eggsactly/arduino-wardriving/mount/central-mount.scad

include <libparameters.scad>;
use <libcantilever.scad>;
use <libtriangles.scad>;

function rotateRoundCant(i, j) = (i == -1) ? (j == -1) ? 315 : 225 : (j == -1) ? 45 : 135;

// Draw the elements
difference() 
{
    union()
    {   
        // Draw the main body
        translate(v = [-plateWidth/2, plateOffsetY, 0])
        {
            minkowski()
            {
                cube([plateWidth, plateLength, plateHeight/2], center = false);
                cylinder(h = plateHeight/2, r = minBodyMargin, center = false, $fn = 360);
            }
        }
    
        // Draw the risers
        for (i = [-1, 1])
        {
            for(j = [-1, 1]){
                translate(v = [i * (featherWingDoublerWidth/2 - screwHoleCenterFromEdge), j*(featherWingDoublerLength/2 - screwHoleCenterFromEdge) - batteryDiameter/2 - batteryMargin, plateHeight]) {
                    cylinder(h = solderHeight, r1 = riserBase, r2 = screwHoleCenterFromEdge, center = false, $fn = 360);
                    // Featherboard support block
                    difference(){
                        // Feather board support
                        rotate([0, 0, rotateRoundCant(i, j)-135])translate([-screwHoleCenterFromEdge, -screwHoleCenterFromEdge])cube([riserBase + screwHoleCenterFromEdge, riserBase + screwHoleCenterFromEdge, solderHeight + circularCantLen + featherBoardThickness]);
                        // Circular Cutout
                        translate([0, 0, solderHeight])cylinder(h = solderHeight, r = screwHoleCenterFromEdge, center = false, $fn = 360);
                        rotate([0, 0, rotateRoundCant(i, j)-135-180]){
                            translate([0, 0, solderHeight])cube([screwHoleCenterFromEdge + 1, screwHoleCenterFromEdge + 1, solderHeight]);
                            translate([-screwHoleCenterFromEdge, 0, solderHeight])cube([screwHoleCenterFromEdge + 1, screwHoleCenterFromEdge + 1, solderHeight]);
                            translate([0, -screwHoleCenterFromEdge, solderHeight])cube([screwHoleCenterFromEdge + 1, screwHoleCenterFromEdge + 1, solderHeight]);
                            translate([0, 0, 0])cube([screwHoleCenterFromEdge + 1, screwHoleCenterFromEdge + 1, solderHeight + 1]);
                        }
                    }
                }
            }      
        }
         
    
        // Draw the switch support
        translate([0, plateOffsetY + 6*fitMargin, plateHeight]) {
            translate([switchWidth/2 + switchSupportWidth, - batConLength, 0])rotate([90, 0, 0])triangle(switchHeight, switchLength, switchSupportWidth + 1/3);
            translate([-switchWidth/2 - switchSupportWidth, -switchLength - batConLength, 0])cube([switchSupportWidth, switchLength, switchHeight]);
            translate([-switchWidth/2 - switchSupportWidth, - batConLength - switchLength, 0])rotate([90, 0, 180])triangle(switchHeight, switchLength, switchSupportWidth + 1/3);
            translate([switchWidth/2, -switchLength - batConLength, 0])cube([switchSupportWidth, switchLength, switchHeight]);
       
        }
        // Draw the battery connector support
        translate([-(featherWingDoublerWidth/2 - screwHoleCenterFromEdge) - batConWidth/2, -(featherWingDoublerLength/2 - screwHoleCenterFromEdge) - batteryDiameter/2 - batteryMargin - batConShroudWidth - screwHoleCenterFromEdge, plateHeight]) {
            translate([0, 0, 0])cube([batConWidth, batConShroudWidth, batConHeight]);
            translate([0, -batConWidth-batConShroudWidth, 0])cube([batConWidth, batConShroudWidth, batConHeight]);
            translate([batConWidth, - batConWidth - batConShroudWidth, 0])rotate([90, 0, -90])triangle(batConHeight, batConShroudWidth, batConWidth);
        }
    
    
    }

    difference()
    {
        // Draw the attachment adaptor hole
        translate(v = [-(bikeMountHeight + 2 * fitMargin)/2, -(bikeMountHeight + 2 * fitMargin)/2, -0.5]) 
        {
            cube([bikeMountHeight + 2 * fitMargin, bikeMountHeight + 2 * fitMargin, plateHeight + 1], center = false);
        }
        // Draw the central cantilever mount
        for(i=[0 : 90 : 270])rotate([0, 0, i])translate([-(bikeMountHeight + 2 * fitMargin)/2, 0, plateHeight - handle_cant_slope_height - handle_cant_errosion_margin - fitMargin])translate([0, (bikeMountHeight + 2 * fitMargin)/2, 0])rotate([0, 90, -90])cantilever(0, central_cant_errosion_margin, central_cant_slope_height, handle_cant_overhang, 0, 0, bikeMountHeight + 2 * fitMargin);
    }

    // Draw the hole for the battery mount
    difference()
    {
        // 
        union(){
            // Draw the main block
            translate([-(batterySheathLength + 2 * fitMargin)/2, batteryPlateOffsetY - 2*fitMargin, -0.5])cube([batterySheathLength + 2 * fitMargin, batteryPlankWidth + 2 * fitMargin, plateHeight + 1]);
            //Draw the near triangle
            translate([-(batterySheathLength + 2 * fitMargin)/2, batteryPlateOffsetY - 2*fitMargin, 0]){
                rotate([0, -90, 180])triangle(4, handle_cant_post_height + handle_cant_slope_height + handle_cant_errosion_margin, batterySheathLength + 2 * fitMargin);
                translate([0, -4, -0.5])cube([batterySheathLength + 2 * fitMargin, 4, 1]);
                translate([0, -0.5, -0.5])cube([batterySheathLength + 2 * fitMargin, 1, handle_cant_post_height + handle_cant_slope_height + handle_cant_errosion_margin]);
            }
            // Draw the far triangle
            translate([(batterySheathLength + 2 * fitMargin)/2, batteryPlateOffsetY - 2*fitMargin + batteryPlankWidth + 2 * fitMargin, 0])rotate([0, 0, 180]){
                rotate([0, -90, 180])triangle(4, handle_cant_post_height + handle_cant_slope_height + handle_cant_errosion_margin, batterySheathLength + 2 * fitMargin);
                translate([0, -4, -0.5])cube([batterySheathLength + 2 * fitMargin, 4, 1]);
                translate([0, -0.5, -0.5])cube([batterySheathLength + 2 * fitMargin, 1, handle_cant_post_height + handle_cant_slope_height + handle_cant_errosion_margin]);
            }
        }
        
        // Draw the battery connect block
        translate([-batterySheathLength/2 - fitMargin, batteryPlateOffsetY + (batteryPlankWidth - batteryBlockLength)/2 - fitMargin, 0])cube([batterySheathLength + 4*fitMargin, batteryBlockLength, handle_cant_errosion_margin + handle_cant_slope_height + handle_cant_post_height + fitMargin]);
    
        // Draw the far cantilever fitting for the batter mount
        translate([0, batteryBlockLength + (batteryPlankWidth - batteryBlockLength)/2 - fitMargin, 0])      
            rotate([0, 0, 0])translate([batterySheathLength/2 + fitMargin, batteryPlateOffsetY, handle_cant_errosion_margin + handle_cant_slope_height + 2*fitMargin])
                rotate([0, -90, 0])
                    cantilever(0, 2, handle_cant_post_height - 2 - 2 * fitMargin, handle_cant_overhang, 0, 0, batterySheathLength + 2 * fitMargin);
        
        // Draw the near cantilever fitting for the battery mount
        translate([0, (batteryPlankWidth - batteryBlockLength)/2 - fitMargin, 0])      
            rotate([0, 0, 0])translate([-batterySheathLength/2 - fitMargin, batteryPlateOffsetY, handle_cant_errosion_margin + handle_cant_slope_height + 2*fitMargin])
                rotate([0, -90, 180])
                    cantilever(0, 2, handle_cant_post_height - 2 - 2 * fitMargin, handle_cant_overhang, 0, 0, batterySheathLength + 2 * fitMargin);
    }
    
    // Draw the little holes to put you fingers in
    for(i = [(bikeMountHeight + 2 * fitMargin)/2, -(bikeMountHeight + 2 * fitMargin)/2])translate([i, 0, plateHeight])sphere(r=fingerHoleRadius, $fn = 60);
        for(i = [(bikeMountHeight + 2 * fitMargin)/2, -(bikeMountHeight + 2 * fitMargin)/2])translate([0, i, plateHeight])sphere(r=fingerHoleRadius, $fn = 60);
       
     // Draw the repo text, lots of nasty hard coding here
    translate([plateWidth/2 + 7, -22, plateHeight-textHeight+0.5])
    {
        rotate([0, 0, 180]){
            translate([0, 0, -0.5])rotate([0, 0, -90])linear_extrude(height=textHeight+1)text(text=repoURL, size = 4.5);
        }
    } 
}
