eggsactly/arduino-wardriving/mount/handlebar-mount-up.scad

include <libparameters.scad>;
use <libcantilever.scad>;

// Move the whole block to start on the X axis
translate([0, -handleBarConnectorSeparation/2, 0])
difference()
{
    union()
    {
        // Draw the main block
        translate([-handleBarDiameter/2 - handleBarMountThickness + attachAdaptorBezzelRad, attachAdaptorBezzelRad  + handleBarConnectorSeparation/2, 0]){
            minkowski()
            {
                cube([handleBarDiameter + 2*handleBarMountThickness-2*attachAdaptorBezzelRad, handleBarDiameter/2 + handleBarMountThickness - 2*attachAdaptorBezzelRad - handleBarConnectorSeparation/2 + mountPostLength, bikeMountHeight/2]);
                cylinder(h = bikeMountHeight/2, r = attachAdaptorBezzelRad, center = false, $fn = 360);
            }
        }
        
        // Draw the left support
        translate([handleBarDiameter/2,  + handleBarConnectorSeparation/2, 0])
            cube([handleBarScrewMountWidth, handleBarMatingPlateThickness, bikeMountHeight]);
        // Draw the right support
        translate([-handleBarDiameter/2 - handleBarScrewMountWidth,  + handleBarConnectorSeparation/2, 0])
            cube([handleBarScrewMountWidth, handleBarMatingPlateThickness, bikeMountHeight]);
        
        // Draw the mount fit
        translate([-bikeMountHeight/2, handleBarDiameter/2 + handleBarMountThickness - handleBarConnectorSeparation/2 + handleBarConnectorSeparation/2 + mountPostLength, 0])
            cube([bikeMountHeight, mountFitHeight, bikeMountHeight]);
        
        // Draw left cantilever
        translate([bikeMountHeight/2 - handle_cant_length_end - handle_cant_overhang, handleBarDiameter/2 + handleBarMountThickness - handleBarConnectorSeparation/2 + handleBarConnectorSeparation/2 + mountPostLength + mountFitHeight, bikeMountHeight - handle_cant_overhang])rotate([0, 180, -90])cantilever (handle_cant_post_height, handle_cant_errosion_margin, handle_cant_slope_height, handle_cant_overhang, handle_cant_length, handle_cant_length_end, bikeMountHeight - 2 * handle_cant_overhang);
        
       // Draw right cantilever
       translate([-bikeMountHeight/2 + handle_cant_length_end + handle_cant_overhang, handleBarDiameter/2 + handleBarMountThickness - handleBarConnectorSeparation/2 + handleBarConnectorSeparation/2 + mountPostLength + mountFitHeight, handle_cant_overhang])rotate([0, 0, 90])cantilever (handle_cant_post_height, handle_cant_errosion_margin, handle_cant_slope_height, handle_cant_overhang, handle_cant_length, handle_cant_length_end, bikeMountHeight - 2 * handle_cant_overhang);
    }
    
    // Draw handlebar hole
    translate([0, 0, -0.5])
        cylinder(h = bikeMountHeight+1, d = handleBarDiameter, center = false, $fn = 360);
    
    // Draw left Screw Hole
    translate([handleBarDiameter/2 + handleBarMountThickness + screwMargin + m3HeadDiameter/2, -0.5  + handleBarConnectorSeparation/2, bikeMountHeight/2])rotate([-90, 0, 0]) cylinder(h = handleBarMatingPlateThickness + 1, d = m3ThreadDiameter, center = false, $fn = 360);
    
    // Draw right nut hole
    translate([handleBarDiameter/2 + handleBarMountThickness + screwMargin + m3HeadDiameter/2, handleBarMatingPlateThickness - m3NutHeight  + handleBarConnectorSeparation/2, bikeMountHeight/2])rotate([-90, 0, 0]) cylinder(h = m3NutHeight + 1, d = m3NutWidth, center = false, $fn = 6);
    
    // Draw Right Screw Hole
    translate([-handleBarDiameter/2 - handleBarMountThickness - screwMargin - m3HeadDiameter/2, -0.5  + handleBarConnectorSeparation/2, bikeMountHeight/2])rotate([-90, 0, 0]) cylinder(h = handleBarMatingPlateThickness + 1, d = m3ThreadDiameter, center = false, $fn = 360);
    
    // Draw right nut hole
    translate([-handleBarDiameter/2 - handleBarMountThickness - screwMargin - m3HeadDiameter/2, handleBarMatingPlateThickness - m3NutHeight  + handleBarConnectorSeparation/2, bikeMountHeight/2])rotate([-90, 0, 0]) cylinder(h = m3NutHeight + 1, d = m3NutWidth, center = false, $fn = 6);
}
