eggsactly/arduino-wardriving/(list of files, cad)

Other CAD files:
mount/libtriangles.scad
