eggsactly/arduino-wardriving/(commit log)

2018-01-02 Moved wardriving sketch into its own folder to work with arduino version 2:1.0.5+dfsg2-4.1
2018-01-17 Replaced lcd with Adafruit_SSD1306.
    [wardriving.ino]
2018-01-17 Removed extranious files.
    [GPSLOG_example.csv, schematic.fzz]
2018-01-17 Added diagram of feather-wing-doubler circuit.
2018-01-17 Removed Ebay link to powerpack.
2018-02-03 Made GPS come in on the dedicated serial port and made hdop print to SD card.
2018-02-03 Added fix detect logic.
    [wardriving.ino]
2018-02-05 Added resistors to the parts list.
2018-02-15 Added battery icon.
2018-02-19 Added code for buttons A and B.
2018-02-20 Added functionality to buttons.
2018-02-21 Changed to fritzing diagram, changed resistor values in parts list.
2018-02-21 Added links to resistors.
2018-03-16 Added initial mount model for the featherwing doubler.
    [mount.scad]
2018-03-16 Added bevel to mount.
    [mount.scad]
2018-03-16 Made centering false, made no parts go below zero on the z axis.
    [mount.scad]
2018-03-16 Added space on plate for battery.
    [mount.scad]
2018-03-16 Gave risers a good 45 degree slope up.
    [mount.scad]
2018-03-17 Added mount attachment point.
    [mount.scad]
2018-03-17 Put parameters in a dedicated parameters file.
    [mount.scad, parameters.scad]
2018-03-17 Added battery adaptor mount.
    [battery-adaptor.scad, parameters.scad]
2018-03-18 Added screw holes for batter mount on main mount.
    [mount.scad, parameters.scad]
2018-03-21 Added the bike mount.
    [bike-mount.scad, parameters.scad]
2018-03-22 Extended slider length
    Extended slider support length to be most of the bike mount width.
    [bike-mount.scad]
2018-03-23 Added Bike mount slider and screw hole.
    [bike-mount.scad, parameters.scad]
2018-03-23 Put bike mount parameters into parameters file.
    [bike-mount.scad, parameters.scad]
2018-03-23 Added rounded outside corners of the bike mount.
    [bike-mount.scad]
2018-03-25 Added handle bar mounts.
    [handle-bar-lower.scad, handle-bar-upper.scad]
2018-03-25 Made the thread diameter just a little bit bigger.
    [parameters.scad]
2018-03-25 Made handle-bar-upper model one object.
    [bike-mount.scad, handle-bar-upper.scad]
2018-03-25 Fixed m3NutWidth calculation to give correct cylinder radius for nut hole.
    [handle-bar-upper.scad]
2018-03-25 Moved more parameters into parameters.scad.
    [handle-bar-lower.scad, handle-bar-upper.scad, parameters.scad]
2018-03-25 Removed extra parameters from handle-bar-upper.scad.
    [handle-bar-upper.scad]
2018-03-26 Renamed mount files, made Makefile.
    [battery-mount.scad, central-mount.scad, handlebar-mount-low.scad, handlebar-mount-up.scad]
2018-03-28 Feather Wing configuration images.
2018-03-28 Added h3 headers for electric setup feather wing sections.
2018-04-01 Added an 8mm separation between the lower and upper handlebar mount.
    [handlebar-mount-low.scad, handlebar-mount-up.scad, parameters.scad]
2018-04-01 Increased the screw radius because actual 3D prints were smaller than radius.
    [parameters.scad]
2018-04-01 Added a cantilever library.
    [libcantilever.scad]
2018-04-01 Switched mount make file to not build anything with lib in front of it.
    [battery-mount.scad, bike-mount.scad, central-mount.scad, handlebar-mount-low.scad, handlebar-mount-up.scad, libcantilever.scad, libparameters.scad]
2018-04-02 Replaced slider on handlebar-mount-up with cantilever.
    [handlebar-mount-up.scad]
2018-04-02 Made the post on the handlebar-mount-up longer and made the cantilevers smaller.
    [handlebar-mount-up.scad]
2018-04-07 Narrowed handle bar attachment cantilevers to allow it to plug in 4 different ways.
    [handlebar-mount-up.scad]
2018-04-07 Moved handlebar-mount-up to start on X axis.
    [handlebar-mount-up.scad]
2018-04-07 Adjusted the cantilever x position and z height.
    [handlebar-mount-up.scad]
2018-04-07 Adjusted the handlebar mount up cantilever length.
    [handlebar-mount-up.scad]
2018-04-10 Renamed cantiliver settings for handlebar mount and put them in libparameters.
    [handlebar-mount-up.scad, libparameters.scad]
2018-04-10 Updated handelbar mount up.
    [handlebar-mount-up.scad]
2018-04-10 Took out attachment adaptor screw holes.
    [central-mount.scad]
2018-04-10 Made attachment adaptor hole the width and length of bikeMountHeight.
    [central-mount.scad, handlebar-mount-up.scad]
2018-04-10 Added cantilever slot on central mount for bike mount.
    [central-mount.scad, libparameters.scad]
2018-04-17 Replaced screw holes on the battery mount with cantilevers.
    [battery-mount.scad, libparameters.scad]
2018-04-28 Used mountFitHeight as the height for the fit peice on the battery mount.
    [battery-mount.scad]
2018-04-29 Replaced the battery screwholes with a slot.
    [central-mount.scad, libparameters.scad]
2018-04-29 Made central mount margins smaller to use less plastic.
    [central-mount.scad, libparameters.scad]
2018-04-29 Added batter connect block to central mount.
    [central-mount.scad]
2018-04-29 Finished the cantilever fitting on the central mount for the battery mount.
    [central-mount.scad]
2018-05-05 Added round cantilevers to central mount for featherwing doubler mount.
    [central-mount.scad, libRoundCantilever.scad, libparameters.scad]
2018-05-11 Made better calculation for plateLength.
    [libparameters.scad]
2018-05-11 Updated comments to central mount.
    [central-mount.scad]
2018-05-11 Fixed calculation for batteryPlateOffsetY.
    [central-mount.scad, libparameters.scad]
2018-05-18 Added mount for power switch.
    [central-mount.scad, libparameters.scad]
2018-05-18 Added spot for batter connector.
    [central-mount.scad]
2018-05-22 Pushed the switch mount back a fitMargin.
    [central-mount.scad]
2018-05-22 Added triangles to the sides of the switch support.
    [central-mount.scad, libtriangles.scad]
2018-05-22 Added triangle to battery connector mount.
    [central-mount.scad]
2018-05-22 Added secondary support surround for featherboard doubler.
    [central-mount.scad, libparameters.scad]
2018-05-23 Added text to repo.
    [central-mount.scad, libparameters.scad]
2018-05-25 Fixed tabbing in central mount.
    [central-mount.scad]
2018-05-25 Added more support for the featherwing doubler on the blocks.
    [central-mount.scad]
2018-05-25 Expanded screwHoleCenterFromEdge by 0.2mm, which controls the radius of the feather board corners.
    [libparameters.scad]
2018-05-25 Put repo text on other side so that it won't be obscured by the battery wire.
    [central-mount.scad]
2018-05-25 Fixed tabing in battery mount.
    [battery-mount.scad]
2018-05-25 Made some adjustments to the mount around the batter mount, to ensure a good fit.
    [central-mount.scad]
2018-05-25 Moved git text to keep it out of the way of the battery.
    [central-mount.scad]
2018-05-25 Removed bike mount part because it was taken out of the design.
    [bike-mount.scad]
2018-05-25 Added comments to the mount Makefile.
2018-05-25 Removed echo in libparameters.
    [libparameters.scad]
2018-05-25 Increased finger hole resolution from 30 to 60.
    [central-mount.scad]
2018-05-25 Added link to socket cap screws.
2018-05-25 Added section for the parts in mount.
2018-05-25 Updated mount images.
2018-05-25 Made it more clear what pins should be attached to which board.
2018-05-26 Added functionality for button C release.
2018-05-27 Got rid of that weird outer union for the bike mount post interface.
    [central-mount.scad]
2018-05-28 Updated button recording code.
2018-06-01 Took out round cantilevers because they don't print well.
    [central-mount.scad, libRoundCantilever.scad]
2018-06-01 Made the repo text just be a difference on the main plate.
    [central-mount.scad]
2018-06-01 Made repo text size 4.5 to increase chances it will print correctly.
    [central-mount.scad]
2018-06-02 Implemented state machine for keeping track of setting menu states.
2018-06-05 Added printout to LCD screen.
2018-06-08 Added logic for missing SD card.
    [wardriving.ino]
2018-06-08 Got SD card print out to fit in 3 lines.
2018-06-08 Made battery and display update at same time and only wrote header when SD is available.
2018-06-08 Fixed printout alignments.
2018-06-08 Kept n from being reset on a lcd screen refresh.
    [wardriving.ino]
2018-06-09 Made print out not give GPS Updating when buttons pressed.
2018-06-11 Changed output for default case of getEncryption() to be UNKNOWN: id.
2018-06-13 Created a os timer and call back to put button detection into.
2018-06-13 Moved button detection code to timerCallback().
2018-06-16 Made printouts more helpful to the user.
2018-06-16 Made python scripts filter out SSIDs that are not valid UTF-8.
2018-06-19 Removed final comma in csv output file to SD card and added csvNumCols to replace complex sizeof(typeof()) business that probably was not working as expected.
    [wardriving.ino]
2018-07-08 Added length test before checking intensity fields and added utf8 test before printing MAC address field.
2018-07-19 Added a note to disconnect the GPS module when programming the board.
2018-09-15 Removed newlines and commas in sampled SSID before storing it.
2018-09-15 Added plot of sampled hotspots.
